ckenaley/uniaxialMTU/README.md

# uniaxialMTU

This directory contains a startup guide ("uniax.startup.pdf") and a sample Arduino sketch ("uniax.code.ino")

Users can download the sample sketch and begin control and fabrication of an MTU. Users will find the startup guide helpful in answering most questions. Beyong that, questions can be directed to Christopher Kenaley (kenaley (at) bc.edu).

One can cite this project, startup, and code with the following:

@article{Kenaley:2018,
author = {Kenaley, Christopher P and Sanin, Andres and Ackerman, Jeanelle and Yoo, John},
title = {{Skin stiffness in ray-finned fishes: Contrasting material properties between species and body regions}},
journal = {Journal of Morphology},
year = {2018},
volume = {},
number = {},
pages = {}
}
